ademuri/colordance-mini/colordance_mini.kicad_pcb

## KiCad design colordance_mini.kicad_pcb (2019-07-06)

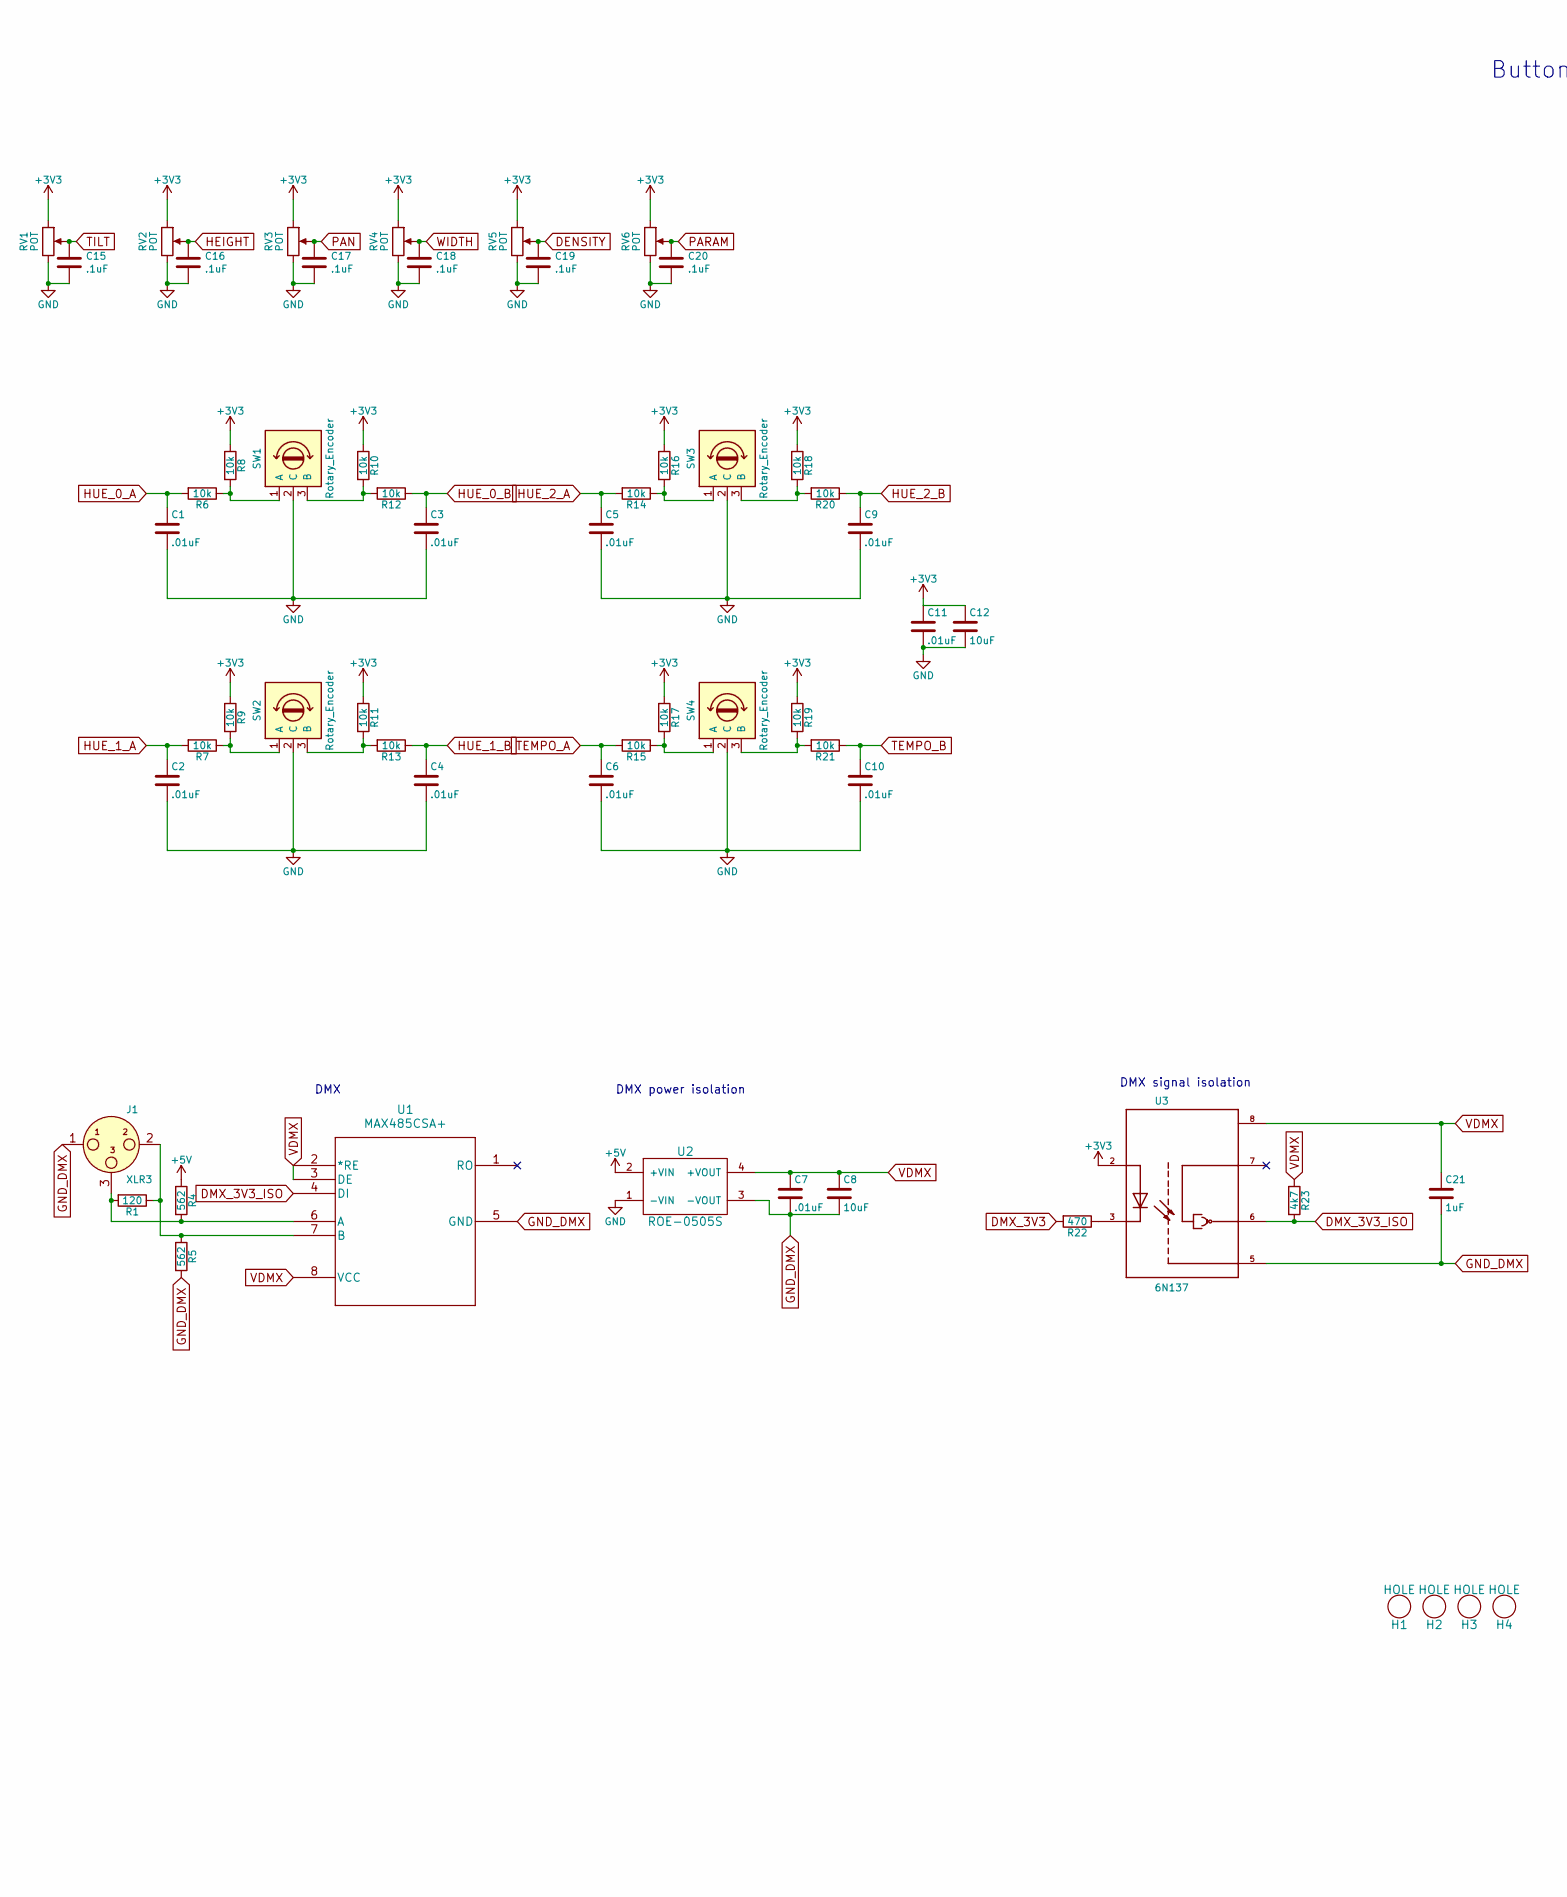
[picture p1: schematic colordance_mini.sch, part in row 1, column 1]

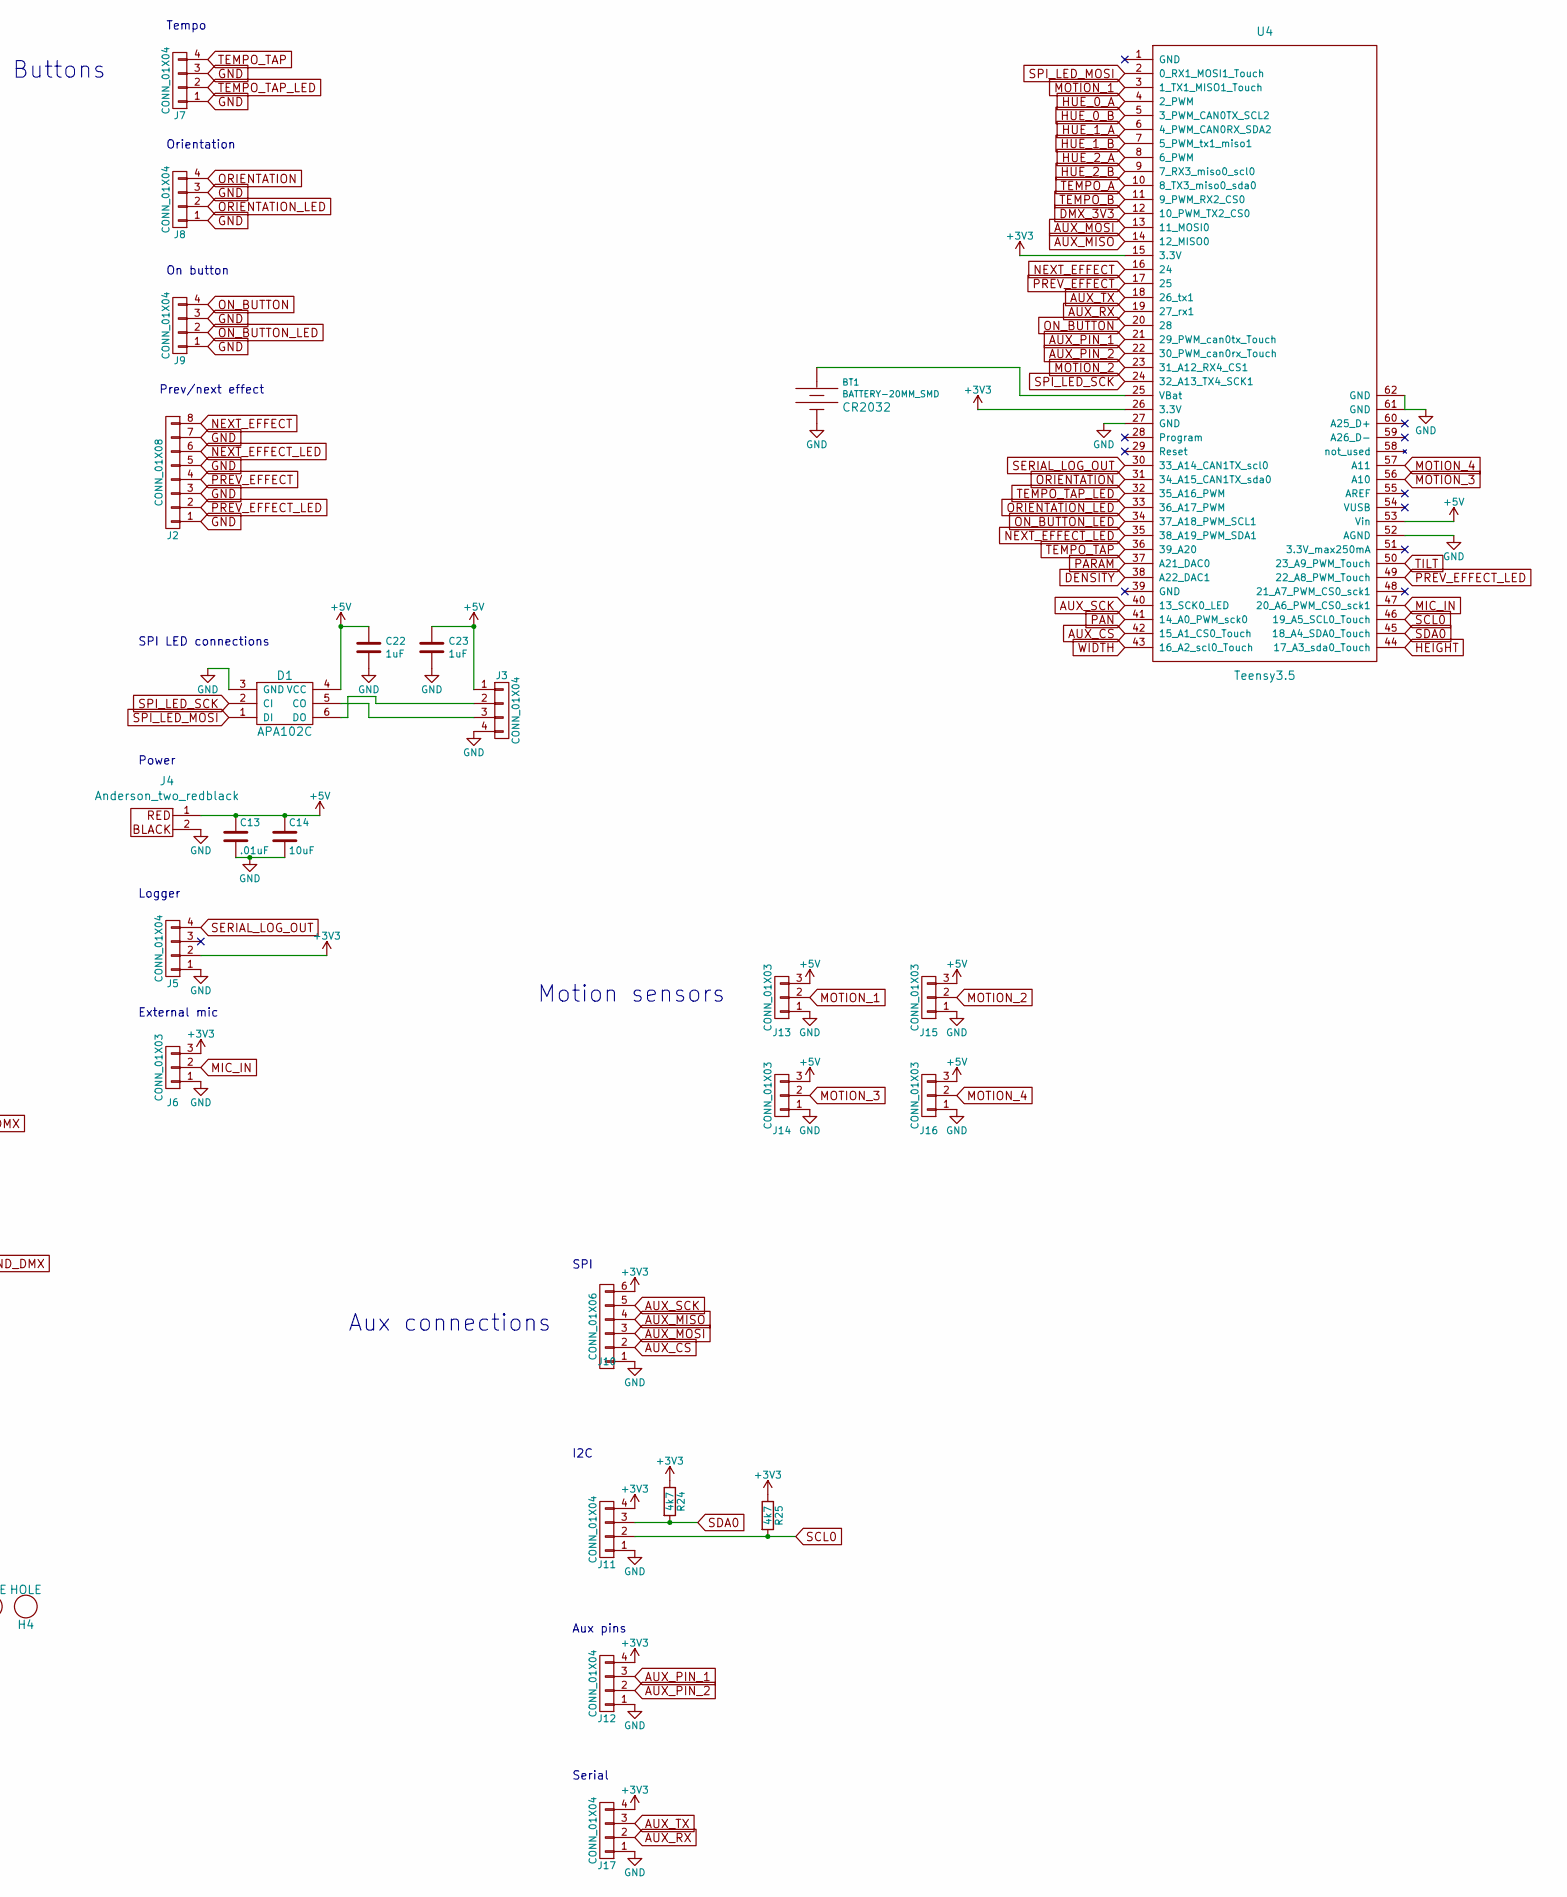
[picture p2: schematic colordance_mini.sch, part in row 1, column 2]

Parts:
BT1: BATTERY-20MM_SMD; BATTCON_20MM
C1, C2, C3, C4, C5, C6, C7, C9, C10, C11, C13: .01uF; C_0603_HandSoldering
C8, C12, C14: 10uF; C_0603_HandSoldering
C15, C16, C17, C18, C19, C20: .1uF; C_0603_1608Metric_Pad1.05x0.95mm_HandSolder
C21, C22, C23: 1uF; C_0603_1608Metric_Pad1.05x0.95mm_HandSolder
D1: APA102C
H1, H2, H3, H4: HOLE; HOLE_M4
J1: XLR3; NC3FAH
J2: CONN_01X08; 1985250_phoenix_8pos_3.5mm
J3: CONN_01X04; PinHeader_1x04_P2.54mm_Vertical
J4: Anderson_two_redblack; Anderson_1337G3_straight_two
J5, J11, J12, J17: CONN_01X04; Pin_Header_Straight_1x04_Pitch2.54mm
J6, J13, J14, J15, J16: CONN_01X03; Pin_Header_Straight_1x03_Pitch2.54mm
J7, J8, J9: CONN_01X04; 1985218_phoenix_4pos_3.5mm
J10: CONN_01X06; Pin_Header_Straight_1x06_Pitch2.54mm
R1: 120; R_0603_HandSoldering
R4, R5: 562; R_0603_HandSoldering
R6, R7, R8, R9, R10, R11, R12, R13, R14, R15, R16, R17, R18, R19, R20, R21: 10k; R_0603_HandSoldering
R22: 470; R_0603_HandSoldering
R23, R24, R25: 4k7; R_0603_HandSoldering
RV1, RV2, RV3, RV4, RV5, RV6: POT; BOURNS_SLIDE_POT_45MM
SW1, SW2, SW3, SW4: Rotary_Encoder; BOURNS_PEC11R_ENCODER
U1: MAX485CSA+; SOIC-8-N
U2: ROE-0505S
U3: 6N137; DIP762W50P254L977H451Q8
U4: Teensy3.5; Teensy35_36

Connections:
+3V3: C11.1, C12.1, J5.2, J6.3, J10.6, J11.4, J12.4, J17.4, R8.1, R9.1, R10.1, R11.1, R16.1, R17.1, R18.1, R19.1, R24.1, R25.1, RV1.1, RV2.1, RV3.1, RV4.1, RV5.1, RV6.1, U3.2 (A), U4.15 (3.3V), U4.26 (3.3V)
+5V: C13.1, C14.1, C22.1, C23.1, D1.4 (VCC), J3.1, J4.1, J13.3, J14.3, J15.3, J16.3, R4.1, U2.2 (+VIN), U4.53 (Vin)
AUX_CS: J10.2, U4.42 (15_A1_CS0_Touch)
AUX_MISO: J10.4, U4.14 (12_MISO0)
AUX_MOSI: J10.3, U4.13 (11_MOSI0)
AUX_PIN_1: J12.3, U4.21 (29_PWM_can0tx_Touch)
AUX_PIN_2: J12.2, U4.22 (30_PWM_can0rx_Touch)
AUX_RX: J17.2, U4.19 (27_rx1)
AUX_SCK: J10.5, U4.40 (13_SCK0_LED)
AUX_TX: J17.3, U4.18 (26_tx1)
DENSITY: C19.1, RV5.2, U4.38 (A22_DAC1)
DMX_3V3: R22.2, U4.12 (10_PWM_TX2_CS0)
DMX_3V3_ISO: R23.2, U1.4 (DI), U3.6 (VO)
GND: BT1.2 (-), C1.2, C2.2, C3.2, C4.2, C5.2, C6.2, C9.2, C10.2, C11.2, C12.2, C13.2, C14.2, C15.2, C16.2, C17.2, C18.2, C19.2, C20.2, C22.2, C23.2, D1.3 (GND), J2.1, J2.3, J2.5, J2.7, J3.4, J4.2, J5.1, J6.1, J7.1, J7.3, J8.1, J8.3, J9.1, J9.3, J10.1, J11.1, J12.1, J13.1, J14.1, J15.1, J16.1, J17.1, RV1.3, RV2.3, RV3.3, RV4.3, RV5.3, RV6.3, SW1.2 (C), SW2.2 (C), SW3.2 (C), SW4.2 (C), U2.1 (-VIN), U4.27 (GND), U4.52 (AGND), U4.61 (GND), U4.62 (GND)
GND_DMX: C7.2, C8.2, C21.2, J1.1, R5.2, U1.5 (GND), U2.3 (-VOUT), U3.5 (GND)
HEIGHT: C16.1, RV2.2, U4.44 (17_A3_sda0_Touch)
HUE_0_A: C1.1, R6.2, U4.4 (2_PWM)
HUE_0_B: C3.1, R12.1, U4.5 (3_PWM_CAN0TX_SCL2)
HUE_1_A: C2.1, R7.2, U4.6 (4_PWM_CAN0RX_SDA2)
HUE_1_B: C4.1, R13.1, U4.7 (5_PWM_tx1_miso1)
HUE_2_A: C5.1, R14.2, U4.8 (6_PWM)
HUE_2_B: C9.1, R20.1, U4.9 (7_RX3_miso0_scl0)
MIC_IN: J6.2, U4.47 (20_A6_PWM_CS0_sck1)
MOTION_1: J13.2, U4.3 (1_TX1_MISO1_Touch)
MOTION_2: J15.2, U4.23 (31_A12_RX4_CS1)
MOTION_3: J14.2, U4.56 (A10)
MOTION_4: J16.2, U4.57 (A11)
NEXT_EFFECT: J2.8, U4.16 (24)
NEXT_EFFECT_LED: J2.6, U4.35 (38_A19_PWM_SDA1)
unnamed: BT1.1 (+), U4.25 (VBat)
unnamed: D1.5 (CO), J3.3
unnamed: D1.6 (DO), J3.2
unnamed: J1.2, R1.1, R5.1, U1.7 (B)
unnamed: J1.3, R1.2, R4.2, U1.6 (A)
unnamed: R6.1, R8.2, SW1.1 (A)
unnamed: R7.1, R9.2, SW2.1 (A)
unnamed: R10.2, R12.2, SW1.3 (B)
unnamed: R11.2, R13.2, SW2.3 (B)
unnamed: R14.1, R16.2, SW3.1 (A)
unnamed: R15.1, R17.2, SW4.1 (A)
unnamed: R18.2, R20.2, SW3.3 (B)
unnamed: R19.2, R21.2, SW4.3 (B)
unnamed: R22.1, U3.3 (C)
ON_BUTTON: J9.4, U4.20 (28)
ON_BUTTON_LED: J9.2, U4.34 (37_A18_PWM_SCL1)
ORIENTATION: J8.4, U4.31 (34_A15_CAN1TX_sda0)
ORIENTATION_LED: J8.2, U4.33 (36_A17_PWM)
PAN: C17.1, RV3.2, U4.41 (14_A0_PWM_sck0)
PARAM: C20.1, RV6.2, U4.37 (A21_DAC0)
PREV_EFFECT: J2.4, U4.17 (25)
PREV_EFFECT_LED: J2.2, U4.49 (22_A8_PWM_Touch)
SCL0: J11.2, R25.2, U4.46 (19_A5_SCL0_Touch)
SDA0: J11.3, R24.2, U4.45 (18_A4_SDA0_Touch)
SERIAL_LOG_OUT: J5.4, U4.30 (33_A14_CAN1TX_scl0)
SPI_LED_MOSI: D1.1 (DI), U4.2 (0_RX1_MOSI1_Touch)
SPI_LED_SCK: D1.2 (CI), U4.24 (32_A13_TX4_SCK1)
TEMPO_A: C6.1, R15.2, U4.10 (8_TX3_miso0_sda0)
TEMPO_B: C10.1, R21.1, U4.11 (9_PWM_RX2_CS0)
TEMPO_TAP: J7.4, U4.36 (39_A20)
TEMPO_TAP_LED: J7.2, U4.32 (35_A16_PWM)
TILT: C15.1, RV1.2, U4.50 (23_A9_PWM_Touch)
VDMX: C7.1, C8.1, C21.1, R23.1, U1.2 (*RE), U1.3 (DE), U1.8 (VCC), U2.4 (+VOUT), U3.8 (VCC)
WIDTH: C18.1, RV4.2, U4.43 (16_A2_scl0_Touch)

Notes on the sheet:
DMX
DMX power isolation
DMX signal isolation
Buttons
Tempo
Orientation
On button
Prev/next effect
SPI LED connections
Power
Motion sensors
Logger
External mic
SPI
Aux connections
I2C
Aux pins
Serial

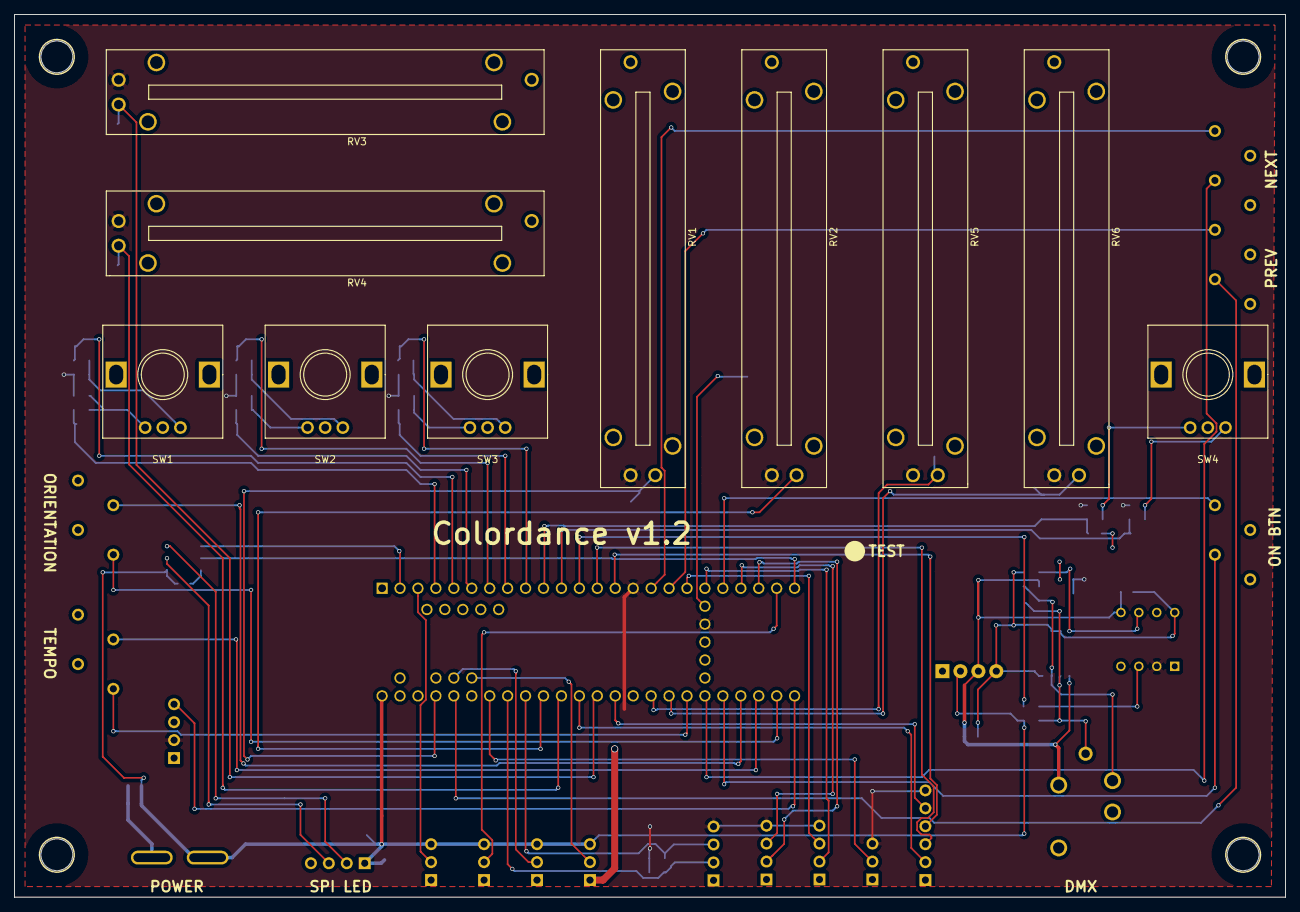
[picture p3: board colordance_mini.kicad_pcb from above]

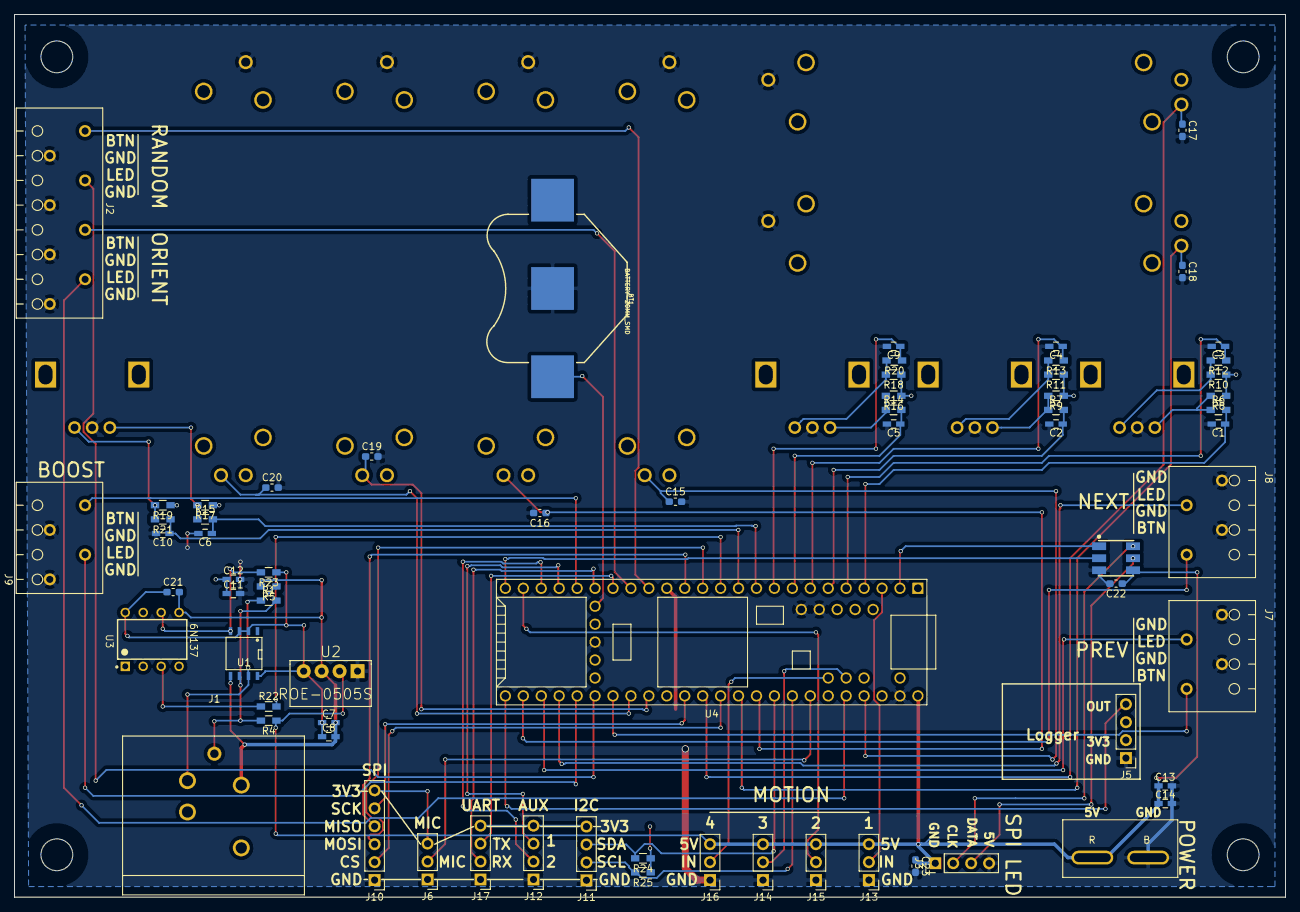
[picture p4: board colordance_mini.kicad_pcb from below]

Board: 2 copper layers, 180.0 x 125.0 mm, 83 parts (69 on the bottom side), 63 nets.
