ademuri/colordance-mini/(commit log)

2017-11-24 Create a schematic
    [colordance_mini.kicad_pcb, colordance_mini.sch]
2017-11-24 Create the PCB. This is rev v1.0, I requested 5 boards from EasyEDA. As-yet untested.
    [colordance_mini.csv, colordance_mini.kicad_pcb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]
2017-11-26 Update gerbers with missing layers
    [colordance_mini-B.Adhes.gbr, colordance_mini-B.Cu.gbr, colordance_mini-B.Mask.gbr, colordance_mini-B.Paste.gbr, colordance_mini-B.SilkS.gbr, colordance_mini-F.Adhes.gbr, colordance_mini-F.Cu.gbr, colordance_mini-F.Mask.gbr]
2017-11-26 Add front panel SVG v1.0
    [colordance_mini.kicad_pcb, colordance_mini.sch]
2018-03-31 Add a teensy and a whole bunch of actuators for v1.1.
    Layout not yet updated.
    [colordance_mini.sch]
2018-04-01 Add an onboard APA102 LED
    [colordance_mini.sch]
2018-04-01 Associate footprints
    [_saved_colordance_mini.sch, colordance_mini.kicad_pcb]
2018-04-02 Rough placement
    [_saved_colordance_mini.sch, colordance_mini.kicad_pcb, colordance_mini.sch]
2018-04-02 Add mounting holes
    [colordance_mini.kicad_pcb]
2018-04-03 Placement finished
    [_saved_colordance_mini.sch, colordance_mini.kicad_pcb, colordance_mini.sch]
2018-04-03 Routing finished
    [colordance_mini.kicad_pcb, colordance_mini.sch]
2018-04-03 Fix holes and generate gerbers
    [colordance_mini-B.Adhes.gbr, colordance_mini-B.CrtYd.gbr, colordance_mini-B.Cu.gbr, colordance_mini-B.Fab.gbr, colordance_mini-B.Mask.gbr, colordance_mini-B.Paste.gbr, colordance_mini-B.SilkS.gbr, colordance_mini-Edge.Cuts.gbr]
2018-04-08 Add schematic and assembly sheet
    [colordance_mini.csv, colordance_mini.kicad_pcb]
2018-04-08 Add test sketches for the button and SPI LED
2018-04-14 Revision 1.1
    - Fix Teensy footprint to not use pads
    - Opto isolator gets 3v3 instead of 5v
    - Separate ground for DMX side
    - Fix DMX connector pinout
    [colordance_mini-B.CrtYd.gbr, colordance_mini-B.Cu.gbr, colordance_mini-B.Mask.gbr, colordance_mini-B.Paste.gbr, colordance_mini-B.SilkS.gbr, colordance_mini-Edge.Cuts.gbr, colordance_mini-F.CrtYd.gbr, colordance_mini-F.Cu.gbr]
2019-07-06 Unknown hardware changes
    [colordance_mini-2019-03-27-22-36-16.sch]
2019-07-06 Hardware revision v1.2:
    - Switch power to Anderson connector
    - Switch SPI LED connector to soldered 4-pin JST
    - Add filter caps to the pots
    - Add a few decoupling caps
    [colordance_mini-B.Adhes.gbr, colordance_mini-B.Cu.gbr, colordance_mini-B.Fab.gbr, colordance_mini-B.Paste.gbr, colordance_mini-B.SilkS.gbr, colordance_mini-B_CrtYd.gbr, colordance_mini-B_Cu.gbr, colordance_mini-B_Mask.gbr]
